kuerbisbeule33/Wifi-Oscilloscope_Hardware/project_library/project_3dmodels/LM4041CEM3-ADJ_NOPB.stp

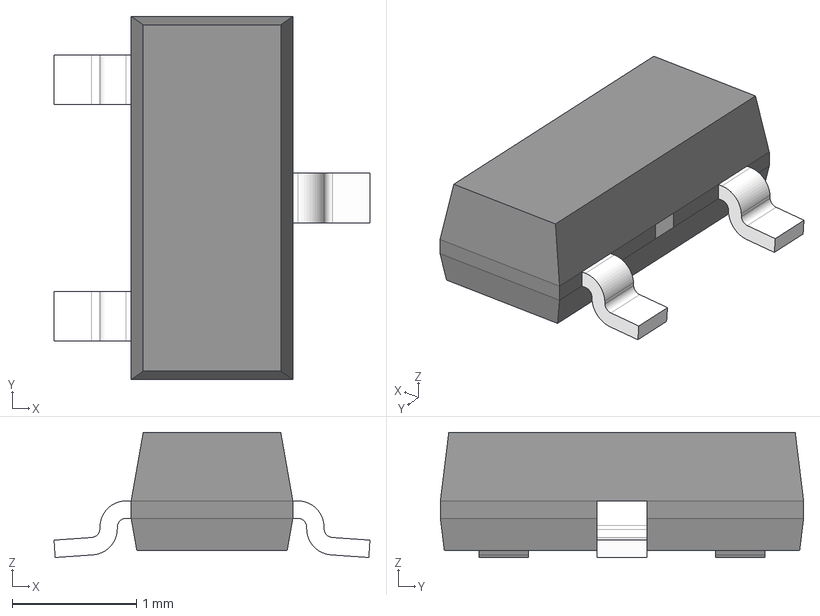
[picture p1: CAD file, 2023-02-16]
project_library/project_3dmodels/LM4041CEM3-ADJ_NOPB.stp
2.54 x 2.92 x 1.01 mm
BODY-SOT
LEAD-SOT x 3
PIN1-ID
TIEBAR
