kuerbisbeule33/Wifi-Oscilloscope_Hardware/project_library/project_3dmodels/MCP4726A1T-E_CH.stp

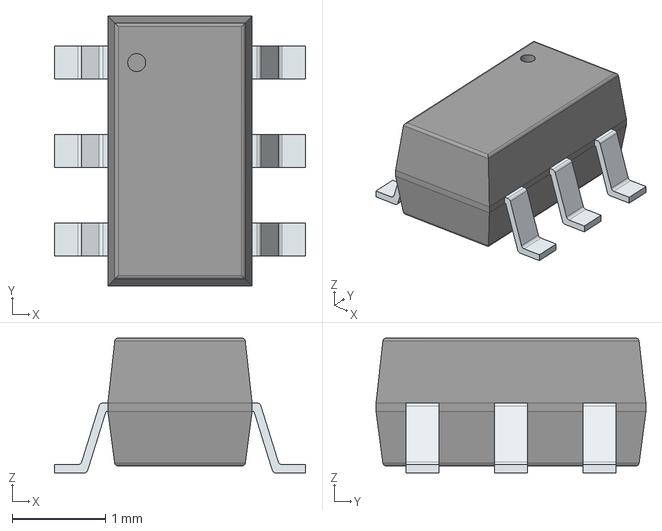
[picture p2: CAD file, 2023-02-07]
project_library/project_3dmodels/MCP4726A1T-E_CH.stp
2.70 x 2.90 x 1.45 mm
PinsArrayLR
