kuerbisbeule33/Wifi-Oscilloscope_Hardware/project_library/project_3dmodels/MCP6S91-E_MS.stp

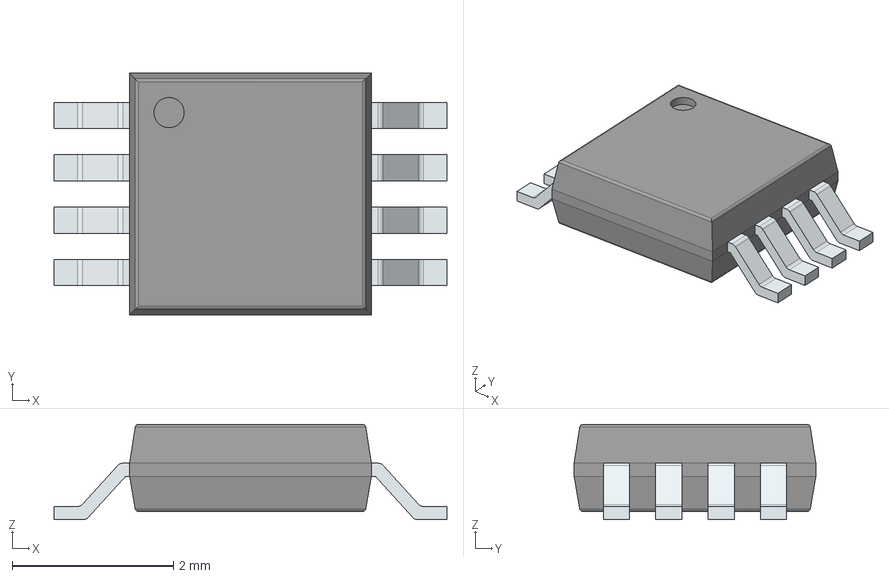
[picture p3: CAD file, 2023-01-23]
project_library/project_3dmodels/MCP6S91-E_MS.stp
4.88 x 3.00 x 1.18 mm
PinsArrayLR
