kuerbisbeule33/Wifi-Oscilloscope_Hardware/project_library/project_3dmodels/JZ300.stp

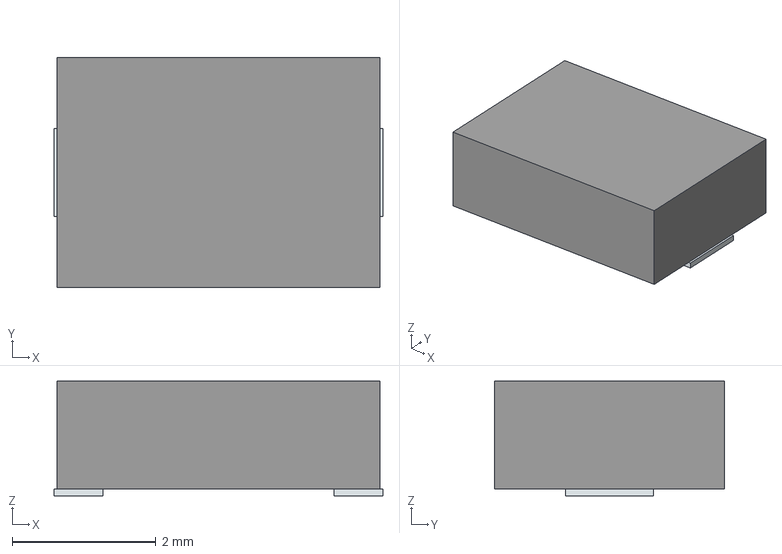
[picture p4: CAD file, 2023-01-23]
project_library/project_3dmodels/JZ300.stp
4.58 x 3.20 x 1.60 mm
Pins
