kuerbisbeule33/Wifi-Oscilloscope_Hardware/project_library/project_3dmodels/USBLC6-2SC6.stp

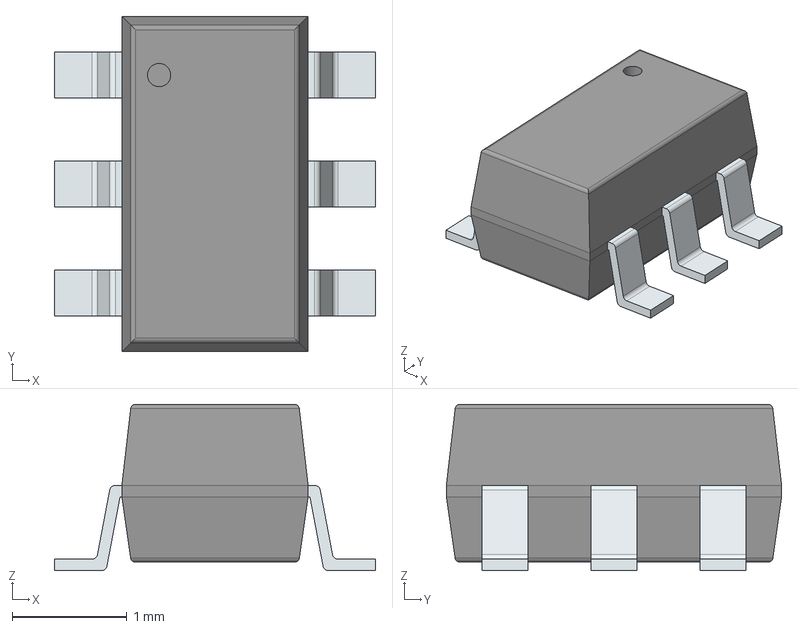
[picture p5: CAD file, 2023-01-23]
project_library/project_3dmodels/USBLC6-2SC6.stp
2.80 x 2.92 x 1.45 mm
PinsArrayLR
