kuerbisbeule33/Wifi-Oscilloscope_Hardware/project_library/project_3dmodels/1043.stp

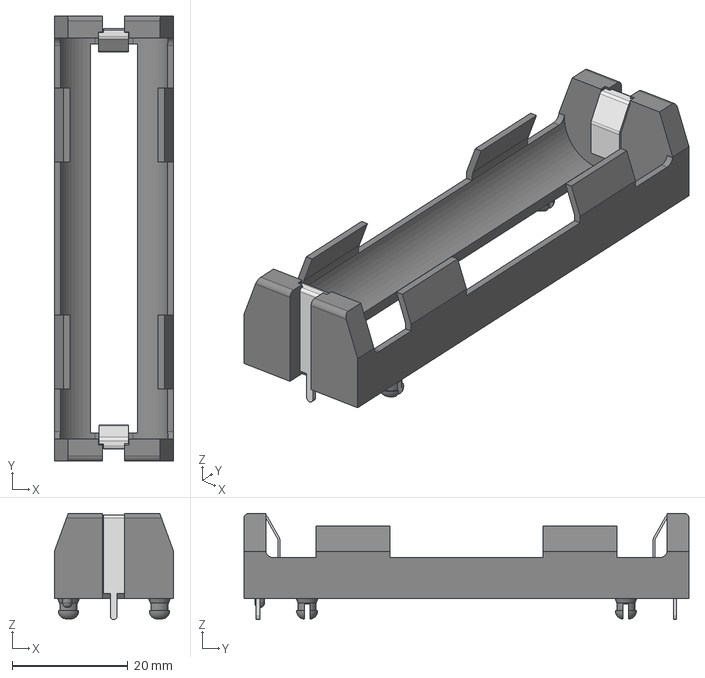
[picture p6: CAD file, 2023-01-23]
project_library/project_3dmodels/1043.stp
20.6 x 77.0 x 18.4 mm
