kuerbisbeule33/Wifi-Oscilloscope_Hardware/project_library/project_3dmodels/AQY210EHAX.stp

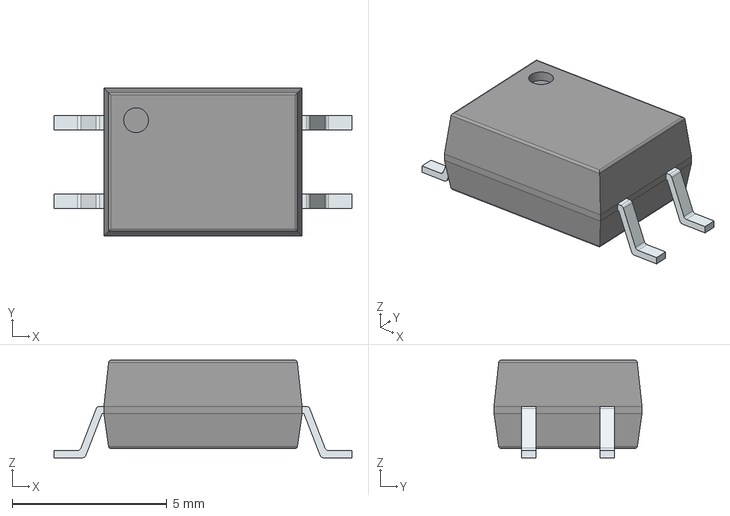
[picture p7: CAD file, 2023-01-23]
project_library/project_3dmodels/AQY210EHAX.stp
9.62 x 4.78 x 3.15 mm
PinsArrayLR
