kuerbisbeule33/Wifi-Oscilloscope_Hardware/project_library/project_3dmodels/TS-1187A-B-A-B.STEP

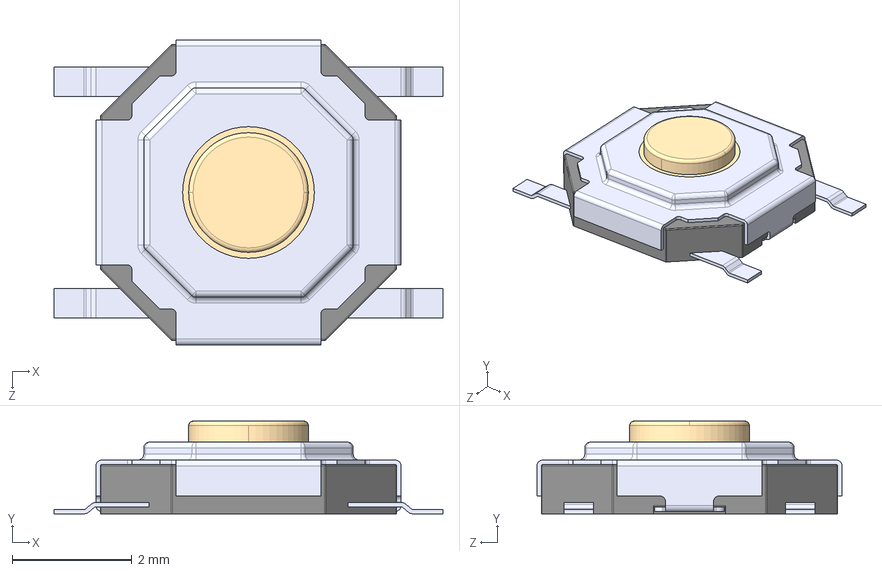
[picture p8: CAD file, 2023-01-23]
project_library/project_3dmodels/TS-1187A-B-A-B.STEP
6.50 x 1.55 x 5.10 mm
