kuerbisbeule33/Wifi-Oscilloscope_Hardware/project_library/project_3dmodels/LC709204FXE-01TBG.stp

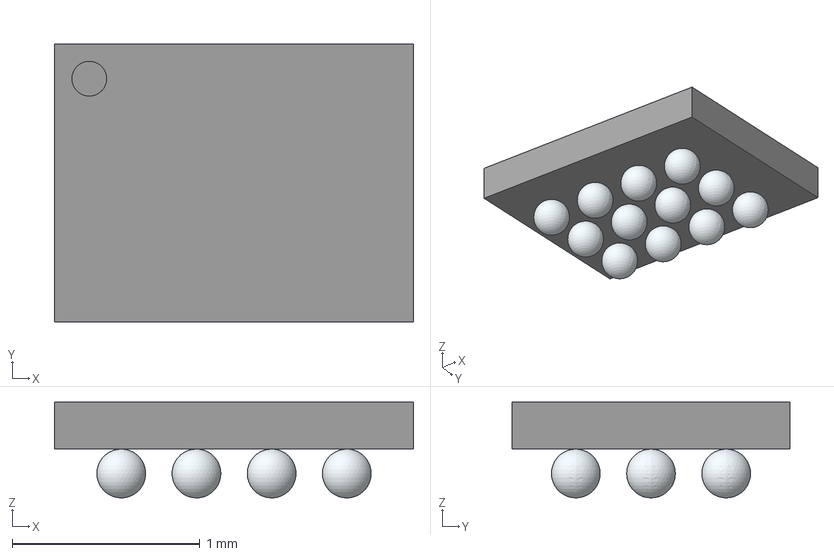
[picture p9: CAD file, 2023-02-16]
project_library/project_3dmodels/LC709204FXE-01TBG.stp
1.91 x 1.48 x 0.51 mm
