kuerbisbeule33/Wifi-Oscilloscope_Hardware/project_library/project_3dmodels/725996-2.stp

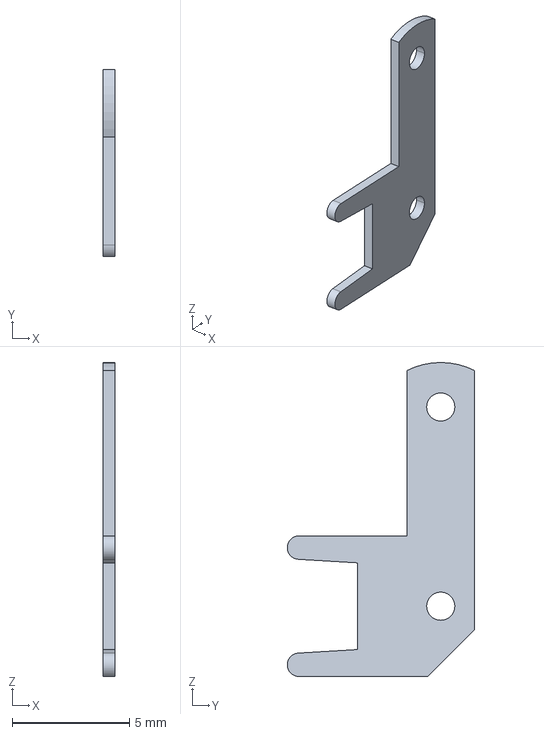
[picture p10: CAD file, 2023-02-16]
project_library/project_3dmodels/725996-2.stp
0.5 x 8.00 x 13.4 mm
