kuerbisbeule33/Wifi-Oscilloscope_Hardware/project_library/project_3dmodels/ADC08351CILQX.stp

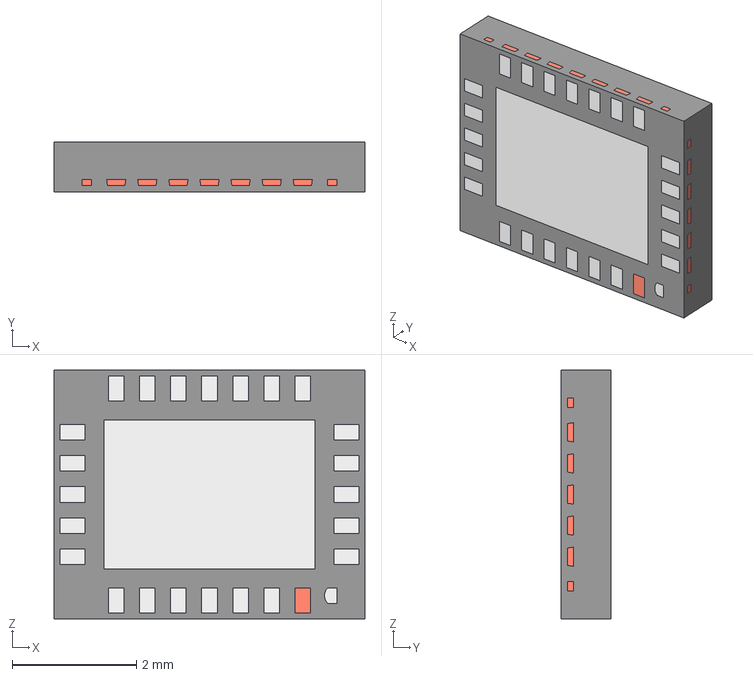
[picture p11: CAD file, 2023-02-07]
project_library/project_3dmodels/ADC08351CILQX.stp
5.00 x 0.8 x 4.00 mm
BODY_LQA24A
FRAME_LQA24A
