kuerbisbeule33/Wifi-Oscilloscope_Hardware/project_library/project_3dmodels/LC709203FQH-01TWG.stp

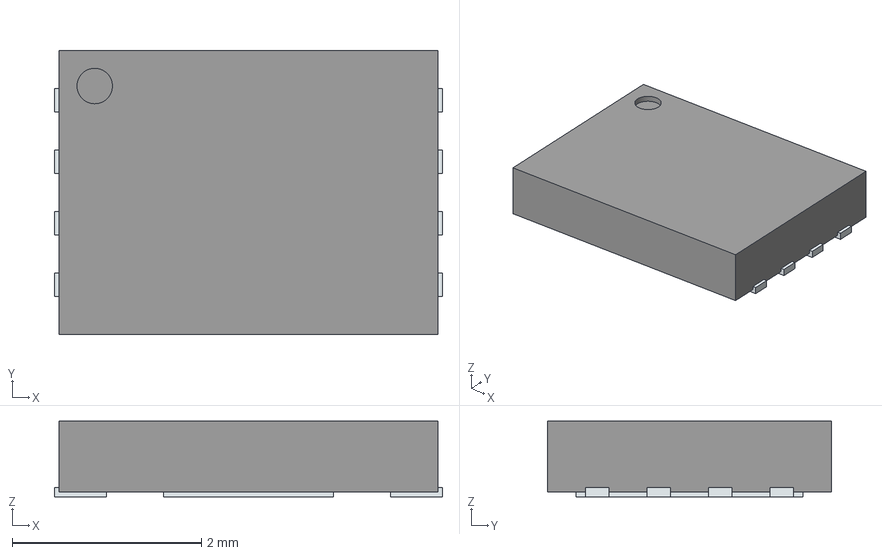
[picture p12: CAD file, 2023-02-02]
project_library/project_3dmodels/LC709203FQH-01TWG.stp
4.10 x 3.00 x 0.8 mm
ThermalPin
PinsArrayLR
