kuerbisbeule33/Wifi-Oscilloscope_Hardware/project_library/project_3dmodels/BQ24074RGTR.stp

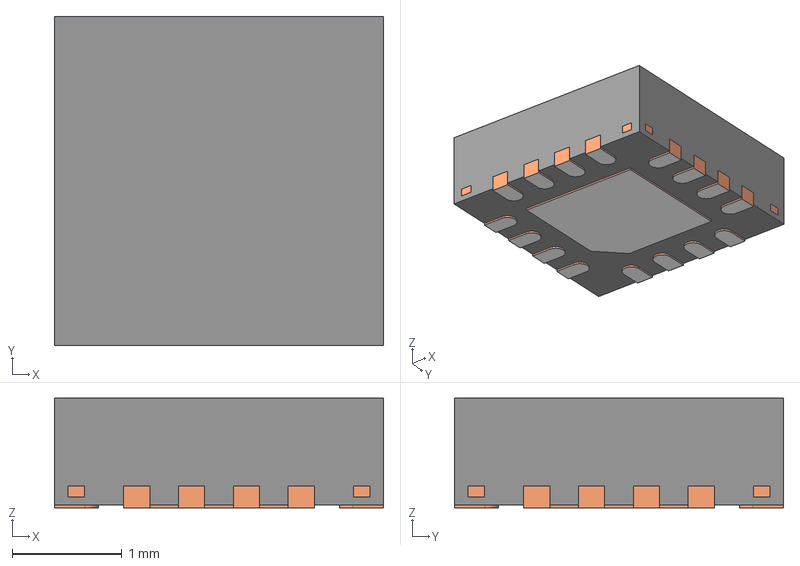
[picture p13: CAD file, 2023-01-23]
project_library/project_3dmodels/BQ24074RGTR.stp
3.00 x 3.00 x 1.00 mm
BODY-QFN
FRAME-RGT0016C
PIN1-ID
