kuerbisbeule33/Wifi-Oscilloscope_Hardware/project_library/project_3dmodels/73100-0105.stp

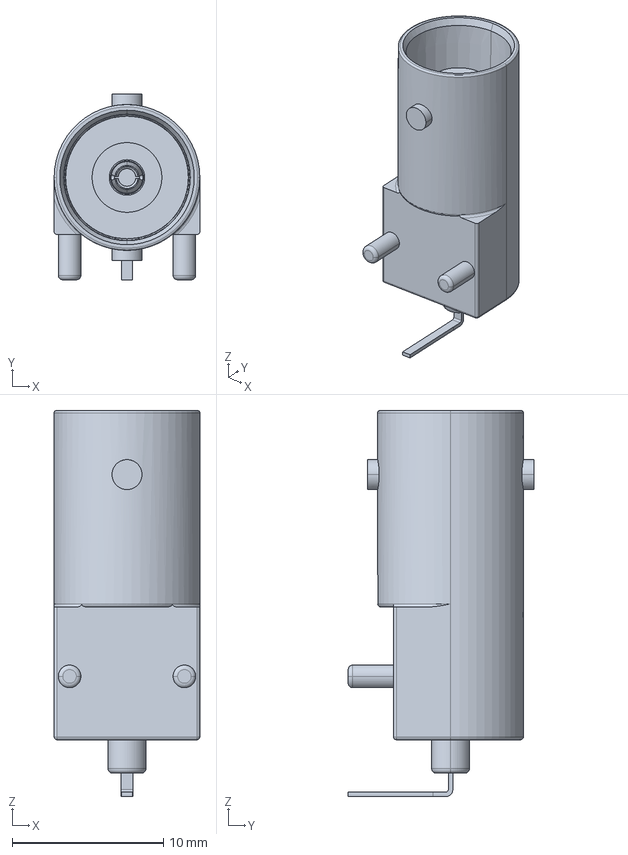
[picture p14: CAD file, 2023-01-23]
project_library/project_3dmodels/73100-0105.stp
9.65 x 12.3 x 25.6 mm
