kuerbisbeule33/Wifi-Oscilloscope_Hardware/test.kicad_pcb

## KiCad design test.kicad_pcb (2023-02-08)

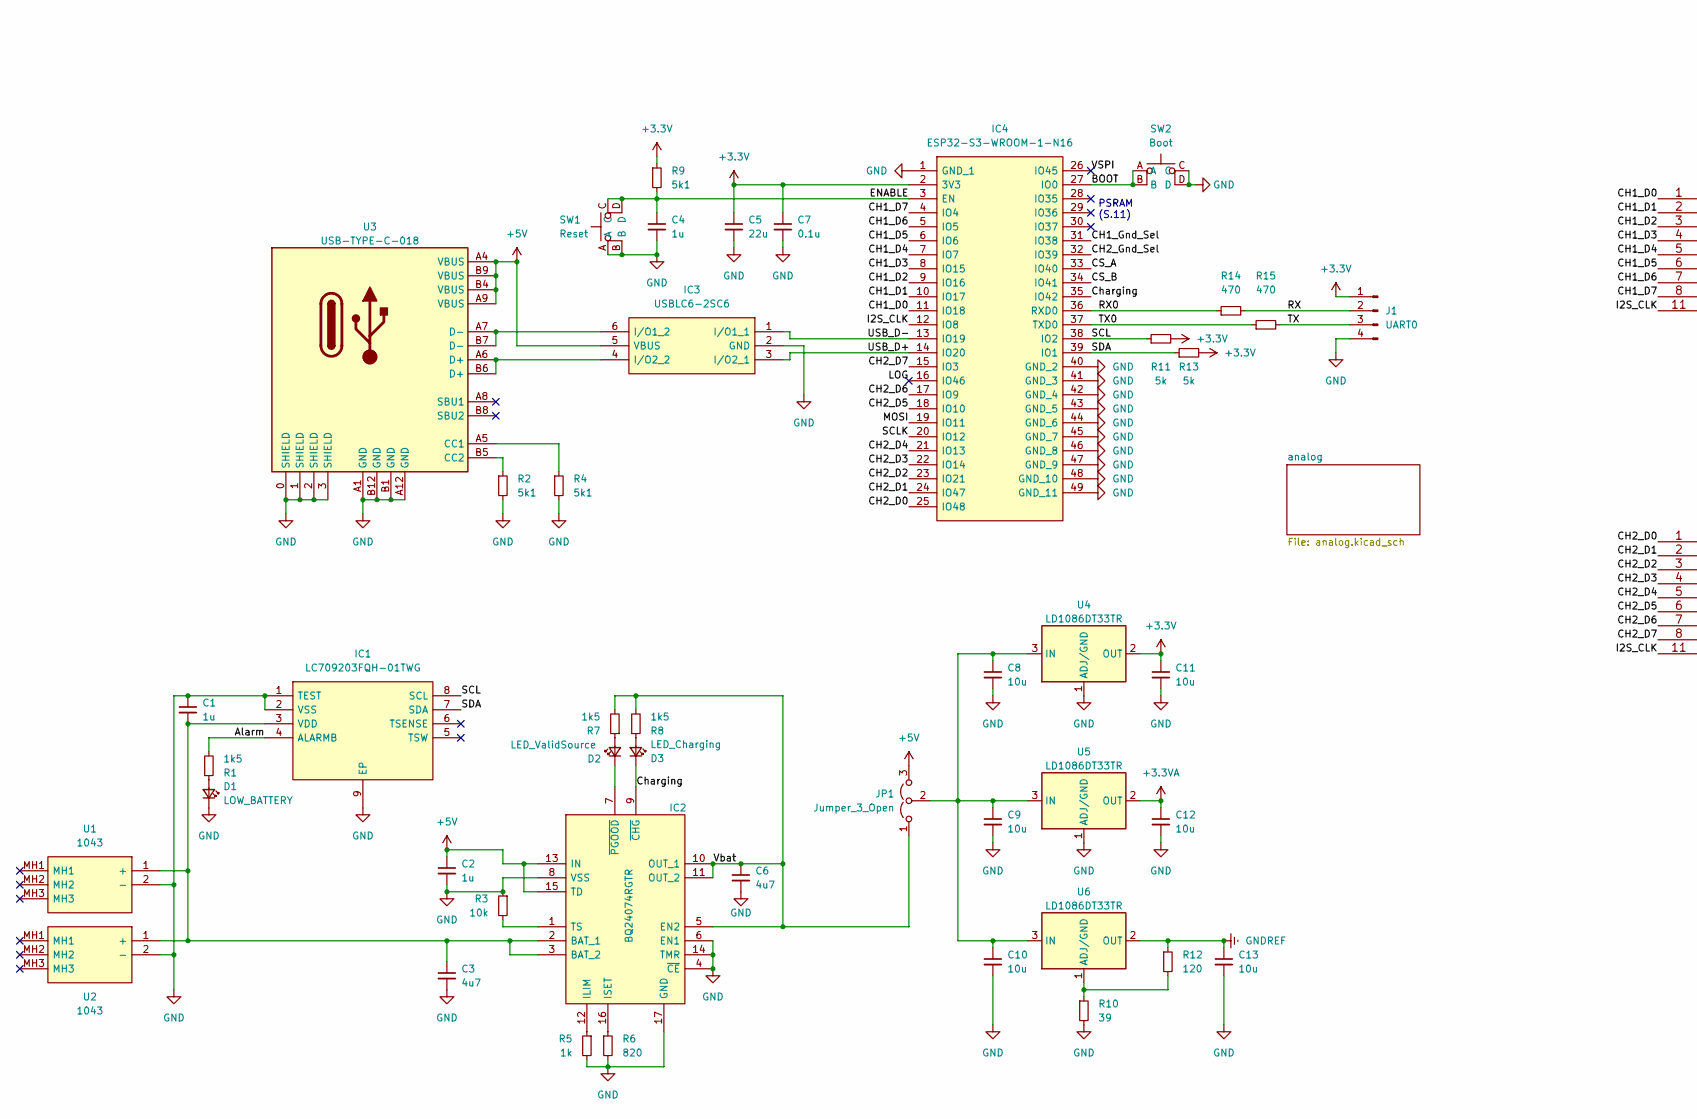
[picture p15: schematic test.kicad_sch, part in row 1, column 1]

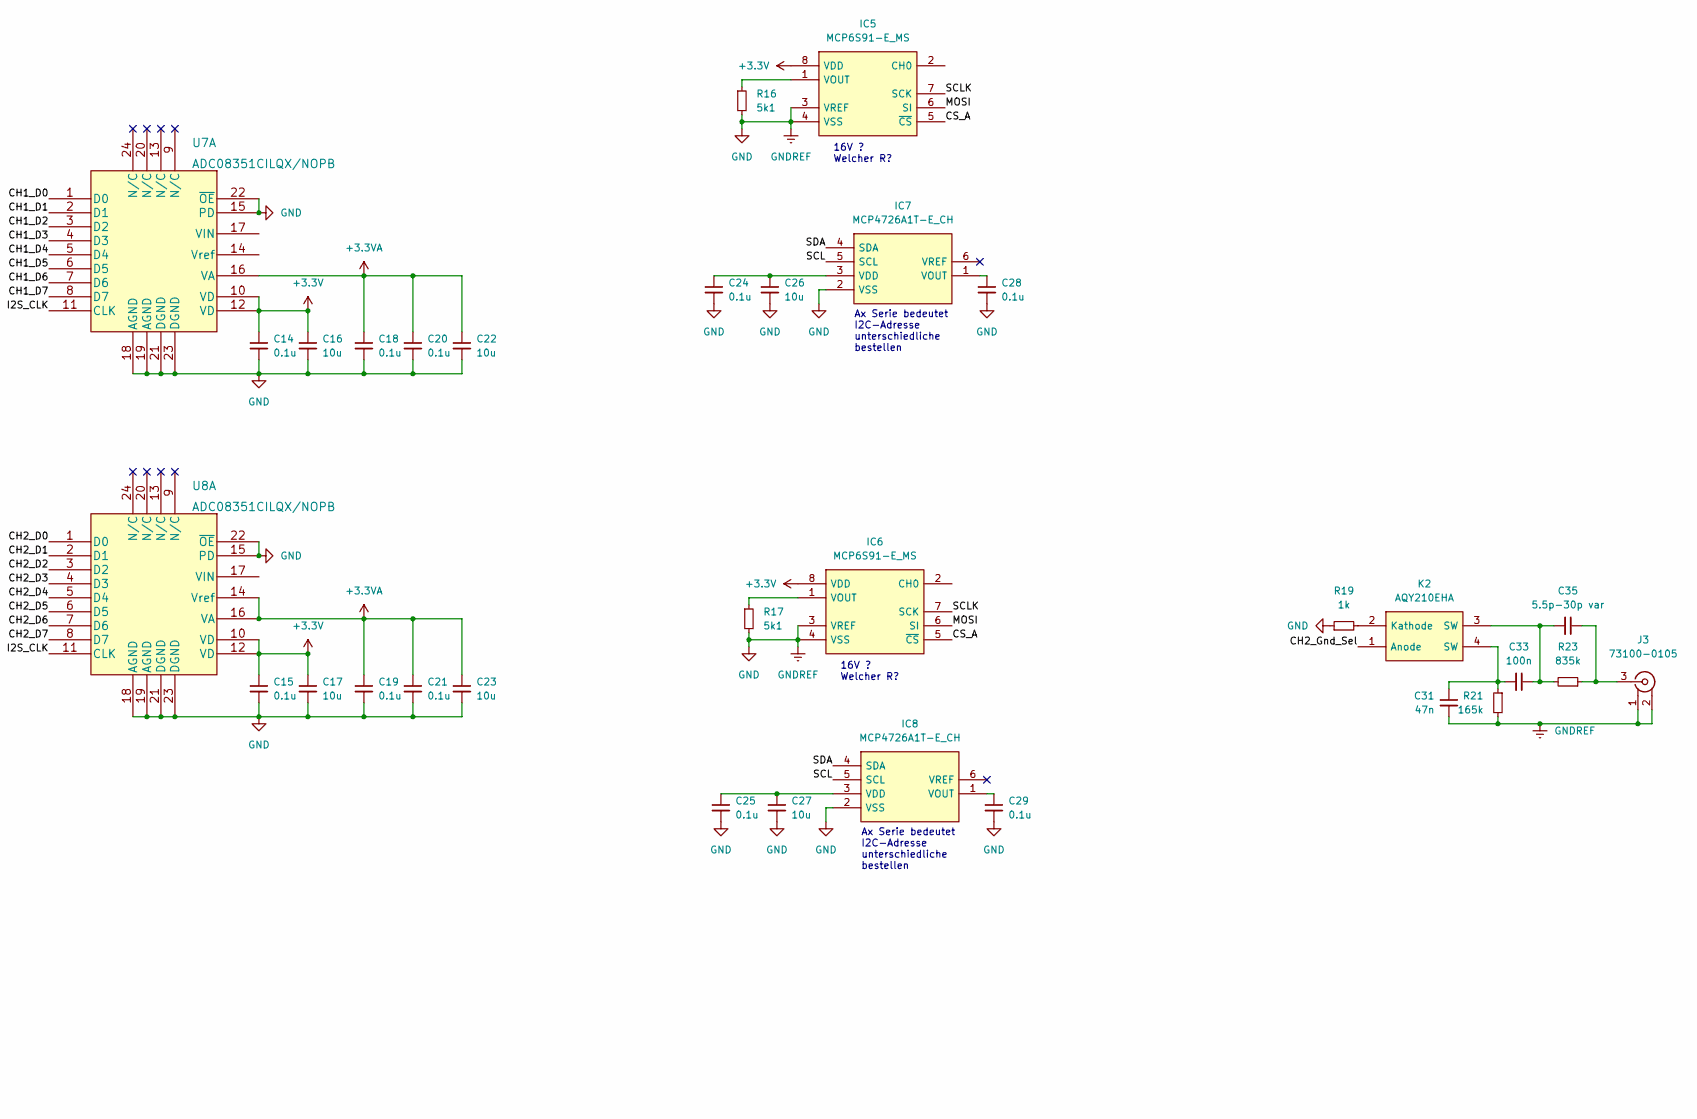
[picture p16: schematic test.kicad_sch, part in row 1, column 2]

Parts:
C1, C2, C4: 1u; C_0805_2012Metric_Pad1.18x1.45mm_HandSolder
C3, C6: 4u7; C_0805_2012Metric_Pad1.18x1.45mm_HandSolder
C5: 22u; C_0805_2012Metric_Pad1.18x1.45mm_HandSolder
C7, C14, C15, C18, C19, C20, C21, C24, C25, C28, C29: 0.1u; C_0805_2012Metric_Pad1.18x1.45mm_HandSolder
C8, C9, C10, C11, C12, C13, C16, C17, C22, C23, C26, C27: 10u; C_0805_2012Metric_Pad1.18x1.45mm_HandSolder
C31: 47n; C_0805_2012Metric_Pad1.18x1.45mm_HandSolder
C33: 100n; C_0805_2012Metric_Pad1.18x1.45mm_HandSolder
C35: 5.5p-30p var; JZ300
D1: LOW_BATTERY; LED_0805_2012Metric_Pad1.15x1.40mm_HandSolder
D2: LED_ValidSource; LED_0805_2012Metric_Pad1.15x1.40mm_HandSolder
D3: LED_Charging; LED_0805_2012Metric_Pad1.15x1.40mm_HandSolder
IC1: LC709203FQH-01TWG; Mouser Part Number 863-LC709203FQH01TWG
IC2: BQ24074RGTR; Mouser Part Number 595-BQ24074RGTR
IC3: USBLC6-2SC6; Mouser Part Number 511-USBLC6-2SC6
IC4: ESP32-S3-WROOM-1-N16; ESP32-S3-WROOM-1; Manufacturer_Part_Number ESP32-S3-WROOM-1-N16; Mouser Part Number 356-ESP32S3WROOM1N16
IC5, IC6: MCP6S91-E_MS; Mouser Part Number 579-MCP6S91-E/MS
IC7, IC8: MCP4726A1T-E_CH; Mouser Part Number 579-MCP4726A1TECH
J1: UART0; PinHeader_1x04_P2.54mm_Vertical
J3: 73100-0105; Mouser Part Number 538-73100-0105
JP1: Jumper_3_Open; PinHeader_1x03_P2.54mm_Vertical
K2: AQY210EHA; AQY210EHAX; Mouser Part Number 769-AQY210EHA
R1, R7, R8: 1k5; R_0805_2012Metric_Pad1.20x1.40mm_HandSolder
R2, R4, R9, R16, R17: 5k1; R_0805_2012Metric_Pad1.20x1.40mm_HandSolder
R3: 10k; R_0805_2012Metric_Pad1.20x1.40mm_HandSolder
R5, R19: 1k; R_0805_2012Metric_Pad1.20x1.40mm_HandSolder
R6: 820; R_0805_2012Metric_Pad1.20x1.40mm_HandSolder
R10: 39; R_0805_2012Metric_Pad1.20x1.40mm_HandSolder
R11, R13: 5k; R_0805_2012Metric_Pad1.20x1.40mm_HandSolder
R12: 120; R_0805_2012Metric_Pad1.20x1.40mm_HandSolder
R14, R15: 470; R_0805_2012Metric_Pad1.20x1.40mm_HandSolder
R21: 165k; R_0805_2012Metric_Pad1.20x1.40mm_HandSolder
R23: 835k; R_0805_2012Metric_Pad1.20x1.40mm_HandSolder
SW1: Reset; SW_TS-1187A-B-A-B
SW2: Boot; SW_TS-1187A-B-A-B
U1, U2: 1043; Mouser Part Number 534-1043
U3: USB-TYPE-C-018; USB-C_SMD-TYPE-C-31-M-12; LCSC C2927038
U4, U5, U6: LD1086DT33TR; TO-252-2
U7, U8: ADC08351CILQX/NOPB; ADC08351CILQX

Connections:
+3.3VA: C12.1, C18.1, C19.1, C20.1, C21.1, C22.1, C23.1, U5.2 (OUT), U7.16 (VA), U8.14 (Vref), U8.16 (VA)
+3V3: C5.1, C7.1, C11.1, C14.1, C15.1, C16.1, C17.1, IC4.2 (3V3), IC5.8 (VDD), IC6.8 (VDD), J1.1, R9.1, R11.2, R13.2, U4.2 (OUT), U7.10 (VD), U7.12 (VD), U8.10 (VD), U8.12 (VD)
+5V: C2.1, IC2.13 (IN), IC2.15 (TD), IC3.5 (VBUS), JP1.3 (B), U1.A4 (VBUS), U1.A9 (VBUS), U1.B4 (VBUS), U1.B9 (VBUS), U3.A4 (VBUS), U3.A9 (VBUS), U3.B4 (VBUS), U3.B9 (VBUS)
/Alarm: IC1.4 (ALARMB), R1.2
/BOOT: IC4.27 (IO0), SW2.A, SW2.B
/CH1_D0: IC4.11 (IO18), U7.1 (D0)
/CH1_D1: IC4.10 (IO17), U7.2 (D1)
/CH1_D2: IC4.9 (IO16), U7.3 (D2)
/CH1_D3: IC4.8 (IO15), U7.4 (D3)
/CH1_D4: IC4.7 (IO7), U7.5 (D4)
/CH1_D5: IC4.6 (IO6), U7.6 (D5)
/CH1_D6: IC4.5 (IO5), U7.7 (D6)
/CH1_D7: IC4.4 (IO4), U7.8 (D7)
/CH1_Gnd_Sel: IC4.31 (IO38); also elsewhere on the board
/CH2_D0: IC4.25 (IO48), U8.1 (D0)
/CH2_D1: IC4.24 (IO47), U8.2 (D1)
/CH2_D2: IC4.23 (IO21), U8.3 (D2)
/CH2_D3: IC4.22 (IO14), U8.4 (D3)
/CH2_D4: IC4.21 (IO13), U8.5 (D4)
/CH2_D5: IC4.18 (IO10), U8.6 (D5)
/CH2_D6: IC4.17 (IO9), U8.7 (D6)
/CH2_D7: IC4.15 (IO3), U8.8 (D7)
/CH2_Gnd_Sel: IC4.32 (IO39), K2.1 (Anode)
/CS_A: IC4.33 (IO40), IC5.5 (~CS), IC6.5 (~CS)
/CS_B: IC4.34 (IO41)
/Charging: D3.1 (K), IC2.9 (~CHG), IC4.35 (IO42)
/ENABLE: C4.1, IC4.3 (EN), R9.2, SW1.C, SW1.D
/I2S_CLK: IC4.12 (IO8), U7.11 (CLK), U8.11 (CLK)
/LOG: IC4.16 (IO46)
/MOSI: IC4.19 (IO11), IC5.6 (SI), IC6.6 (SI)
/RX: J1.2, R14.2
/RX0: IC4.36 (RXD0), R14.1
/SCL: IC1.8 (SCL), IC4.38 (IO2), IC7.5 (SCL), IC8.5 (SCL), R11.1
/SCLK: IC4.20 (IO12), IC5.7 (SCK), IC6.7 (SCK)
/SDA: IC1.7 (SDA), IC4.39 (IO1), IC7.4 (SDA), IC8.4 (SDA), R13.1
/TX: J1.3, R15.2
/TX0: IC4.37 (TXD0), R15.1
/USB_D+: IC3.3 (I/O2_1), IC4.14 (IO20)
/USB_D-: IC3.1 (I/O1_1), IC4.13 (IO19)
/VSPI: IC4.26 (IO45)
/Vbat: C6.1, IC2.5 (EN2), IC2.10 (OUT_1), IC2.11 (OUT_2), JP1.1 (A), R7.2, R8.2
unnamed: C8.1, C9.1, C10.1, JP1.2 (C), U4.3 (IN), U5.3 (IN), U6.3 (IN)
unnamed: C24.1, C26.1, IC7.3 (VDD)
unnamed: C25.1, C27.1, IC8.3 (VDD)
unnamed: C28.1, IC7.1 (VOUT)
unnamed: C29.1, IC8.1 (VOUT)
unnamed: C31.1, C33.2, K2.4 (SW), R21.1
unnamed: C33.1, C35.2, K2.3 (SW), R23.2
unnamed: C35.1, J3.3, R23.1
unnamed: D1.2 (A), R1.1
unnamed: D2.1 (K), IC2.7 (~PGOOD)
unnamed: D2.2 (A), R7.1
unnamed: D3.2 (A), R8.1
unnamed: IC2.1 (TS), R3.2
unnamed: U1.A6 (D+), U1.B6 (D+)
unnamed: U1.A7 (D-), U1.B7 (D-)
unnamed: IC2.12 (ILIM), R5.1
unnamed: IC2.16 (ISET), R6.1
unnamed: IC3.4 (I/O2_2), U3.A6 (D+), U3.B6 (D+)
unnamed: IC3.6 (I/O1_2), U3.A7 (D-), U3.B7 (D-)
unnamed: IC5.1 (VOUT), R16.1
unnamed: IC6.1 (VOUT), R17.1
unnamed: K2.2 (Kathode), R19.2
unnamed: R2.1, U1.B5 (CC2), U3.B5 (CC2)
unnamed: R4.1, U1.A5 (CC1), U3.A5 (CC1)
unnamed: R10.1, R12.2, U6.1 (ADJ/GND)

Notes on the sheet:
PSRAM (S.11)
16V ? Welcher R?
Ax Serie bedeutet I2C-Adresse unterschiedliche bestellen

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
Board: 4 copper layers, 85 parts (6 on the bottom side), 68 nets, no tracks yet.

Other parts of the board:
C30: 47n; C_0805_2012Metric_Pad1.18x1.45mm_HandSolder
C32: 100n; C_0805_2012Metric_Pad1.18x1.45mm_HandSolder
C34: 5.5p-30p var; JZ300
J2: 73100-0105
K1: AQY210EHA; AQY210EHAX
R18: 1k; R_0805_2012Metric_Pad1.20x1.40mm_HandSolder
R20: 100k; R_0805_2012Metric_Pad1.20x1.40mm_HandSolder
R22: 910k; R_0805_2012Metric_Pad1.20x1.40mm_HandSolder
U1#2: 1043

Their connections:
/CH1_Gnd_Sel: K1.1 (Anode); also elsewhere on the board
unnamed: C30.1, C32.2, K1.4 (SW), R20.1
unnamed: C32.1, C34.2, K1.3 (SW), R22.2
unnamed: C34.1, J2.3, R22.1
unnamed: K1.2 (Kathode), R18.2
