kuerbisbeule33/Wifi-Oscilloscope_Hardware/(commit log)

2023-01-23 esp32 and power
    added first try of battery, connecotrs and esp32.
    [1043.stp, 73100-0105.stp, AQY210EHAX.stp, BQ24074RGTR.stp, TS-1187A-B-A-B.STEP, USBLC6-2SC6.stp, test.kicad_pcb, test.kicad_sch]
2023-01-23 first try of front end
    [JZ300.stp, MAX19506ETM+.stp, MCP6S91-E_MS.stp, test.kicad_pcb, test.kicad_sch]
2023-01-26 test changes
    [test.kicad_sch]
2023-02-02 added battery monitoring
    [LC709203FQH-01TWG.stp, test.kicad_sch]
2023-02-07 change esp-pins for parallel adc input and correct bootstrap pins
    [MAX19506ETM+.stp, test.kicad_sch]
2023-02-07 added simpler 40Msps adc
    [ADC08351CILQX.stp]
2023-02-07 added dac and changed switch, gain
    [MCP4726A1T-E_CH.stp, test.kicad_pcb, test.kicad_sch]
2023-02-08 grouped footprints
    [test.kicad_pcb, test.kicad_sch]
2023-02-08 groups new aranged
    [test.kicad_sch]
2023-02-08 added symmetric voltage and input stage
    [test.kicad_sch]
2023-02-16 changed analog
    [analog.kicad_sch, test.kicad_pcb, test.kicad_sch]
2023-02-16 Changed Power Suply to seperate sheet and added changed parts
    [725996-2.stp, LC709204FXE-01TBG.stp, LM4041CEM3-ADJ_NOPB.stp, PowerSupply.kicad_sch, analog.kicad_sch, test.kicad_sch]
2023-02-16 added connector part
    [PowerSupply.kicad_sch, test.kicad_sch]
2023-02-16 added Bus for esp and adc
2023-02-16 changed global labels, and delete analog file to solve merge
    [PowerSupply.kicad_sch, analog.kicad_sch, test.kicad_sch]
